MonkeyBoy122/Magnet-Rink-Airless-Hockey/BOM.csv

Item | Qty | Supplier | Cost/item | Total Cost | link
Estimated total shipping | 1 |  |  | $0.00
