MonkeyBoy122/Magnet-Rink-Airless-Hockey/pull_test_coupon.stl

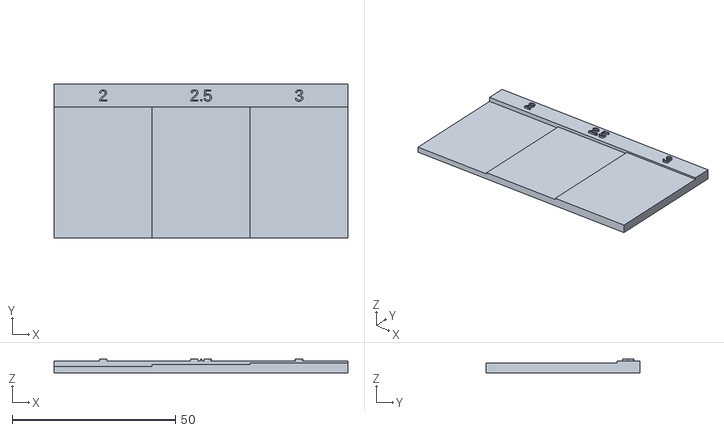
[picture p7: CAD file, 2026-10-18]
pull_test_coupon.stl
90.0 x 47.0 x 4.20
