MonkeyBoy122/Magnet-Rink-Airless-Hockey/wall_tl.stl

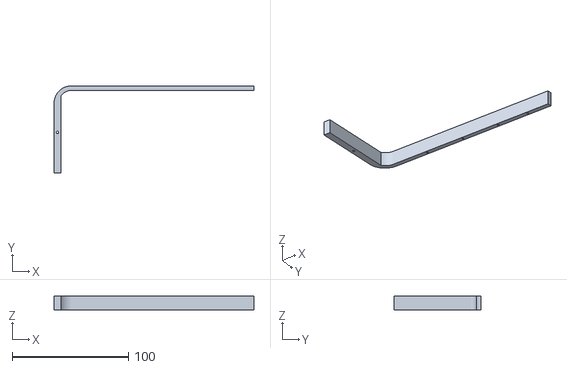
[picture p8: CAD file, 2026-10-18]
wall_tl.stl
172.0 x 75.0 x 12.0
