MonkeyBoy122/Magnet-Rink-Airless-Hockey/bracket_seam.stl

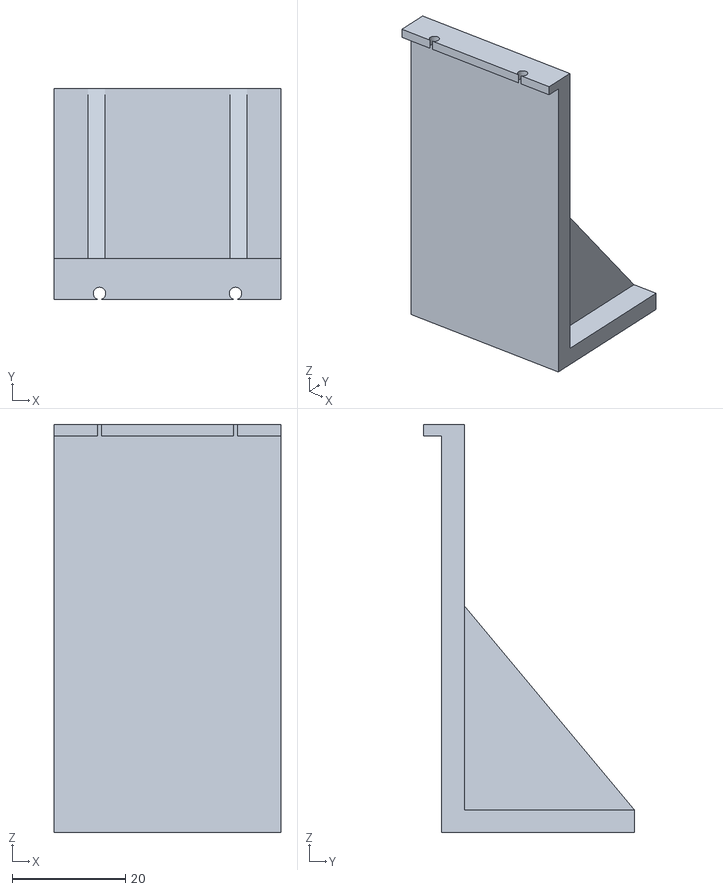
[picture p9: CAD file, 2026-10-18]
bracket_seam.stl
40.0 x 37.2 x 72.0
