MonkeyBoy122/Magnet-Rink-Airless-Hockey/test_joint_b.stl

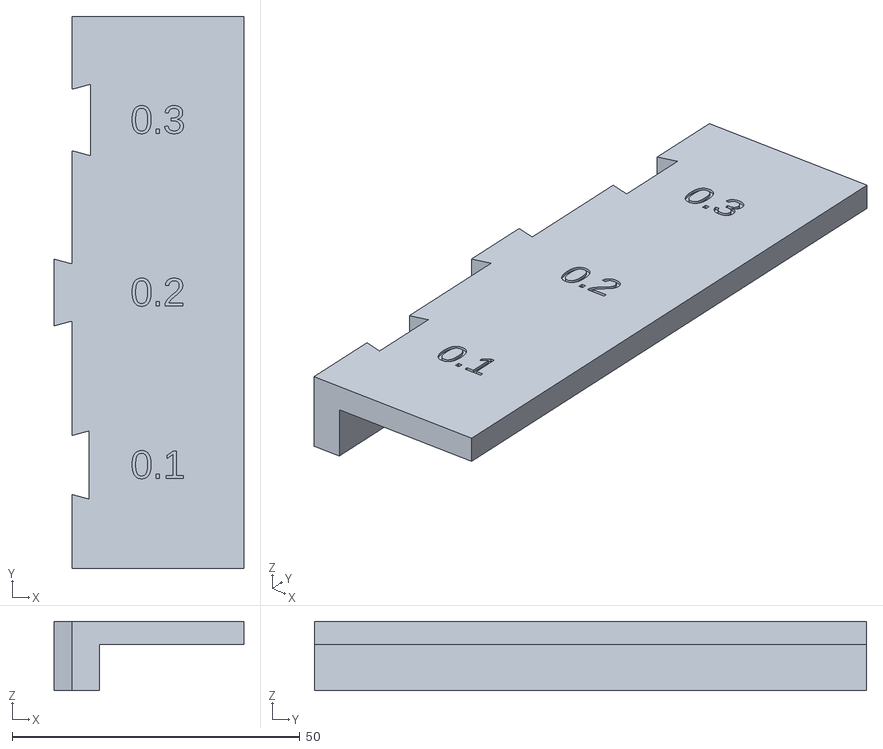
[picture p10: CAD file, 2026-10-18]
test_joint_b.stl
33.0 x 96.0 x 12.0
