MonkeyBoy122/Magnet-Rink-Airless-Hockey/striker.stl

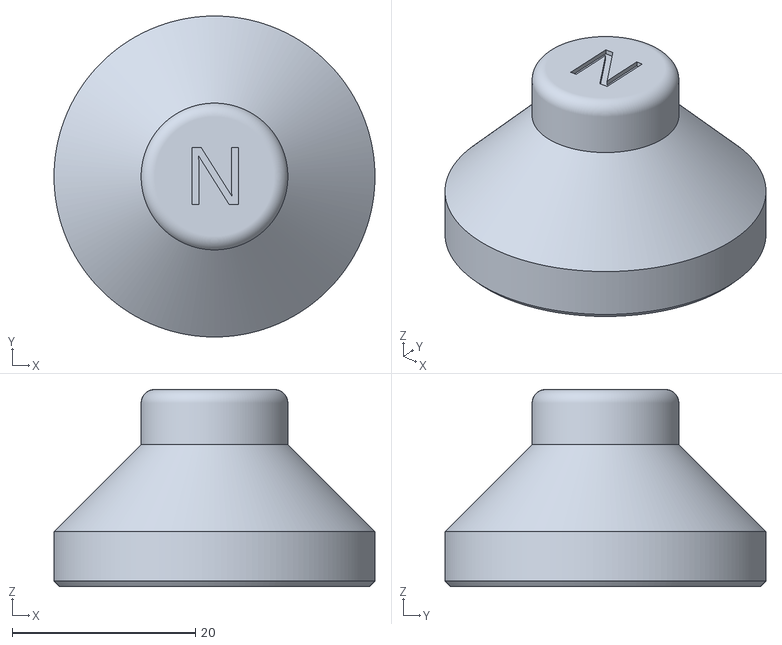
[picture p11: CAD file, 2026-10-18]
striker.stl
35.0 x 35.0 x 21.5
