MonkeyBoy122/Magnet-Rink-Airless-Hockey/rink_half.stl

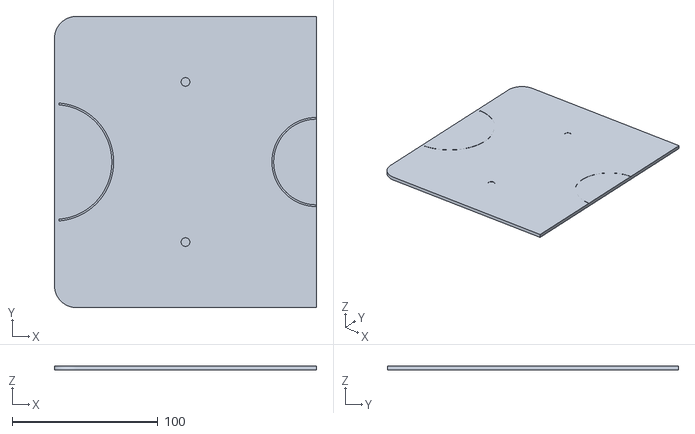
[picture p12: CAD file, 2026-10-18]
rink_half.stl
180.0 x 200.0 x 3.00
