MonkeyBoy122/Magnet-Rink-Airless-Hockey/wand.stl

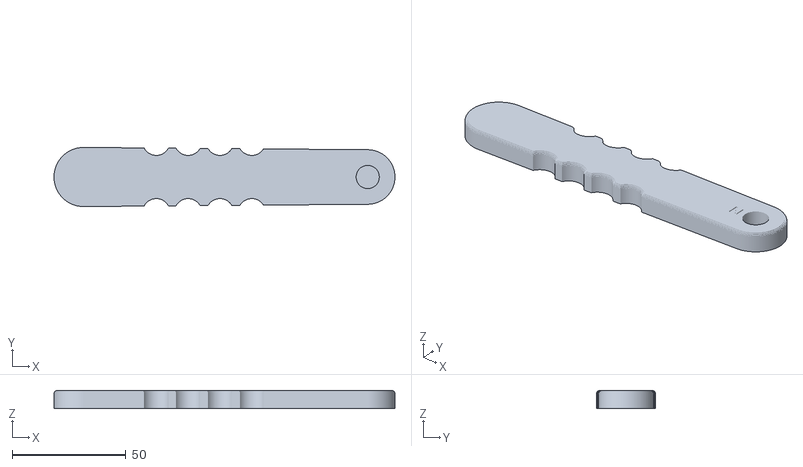
[picture p13: CAD file, 2026-10-18]
wand.stl
150.0 x 26.0 x 8.00
