MonkeyBoy122/Magnet-Rink-Airless-Hockey/rink_right.stl

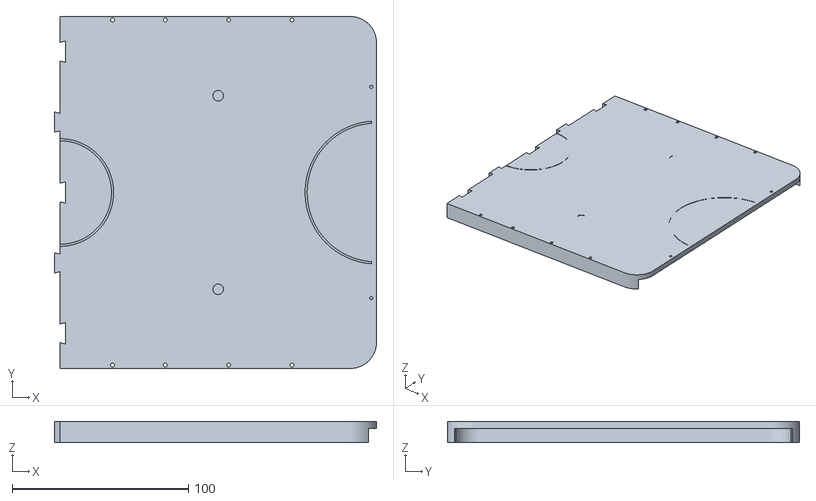
[picture p14: CAD file, 2026-10-18]
rink_right.stl
183.0 x 200.0 x 12.0
