MonkeyBoy122/Magnet-Rink-Airless-Hockey/wand_magnets.stl

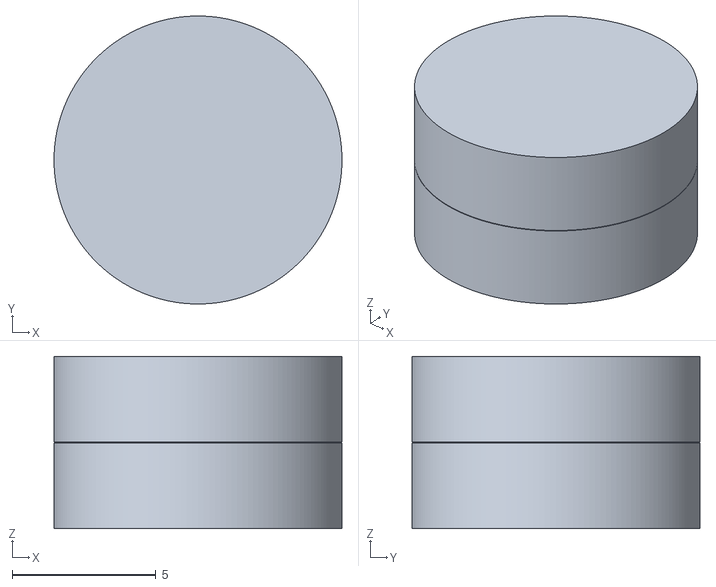
[picture p15: CAD file, 2026-10-18]
wand_magnets.stl
10.0 x 10.0 x 5.98
