MonkeyBoy122/Magnet-Rink-Airless-Hockey/puck.stl

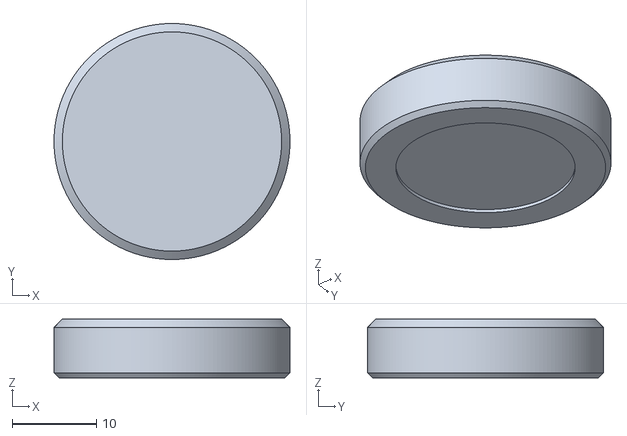
[picture p16: CAD file, 2026-10-18]
puck.stl
28.0 x 28.0 x 7.00
