MonkeyBoy122/Magnet-Rink-Airless-Hockey/bridge.stl

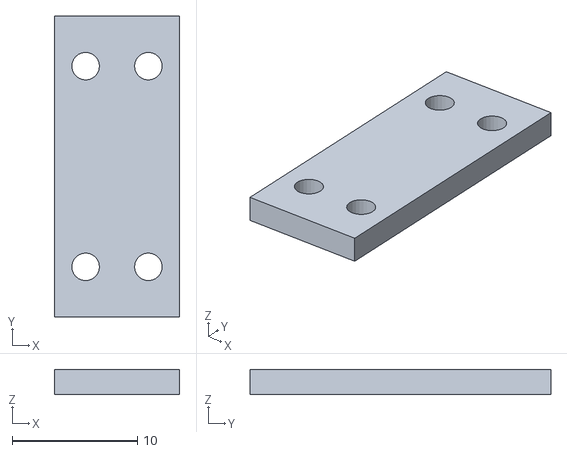
[picture p18: CAD file, 2026-10-18]
bridge.stl
10.0 x 24.0 x 2.00
