MonkeyBoy122/Magnet-Rink-Airless-Hockey/(list of files, cad)

Other CAD files:
bracket_end.stl
wall_tr.stl
wall_br.stl
rink_left.stl
wall_bl.stl
day3.scad
